RonakornST/CAN_Shield/CAN_Shield.step

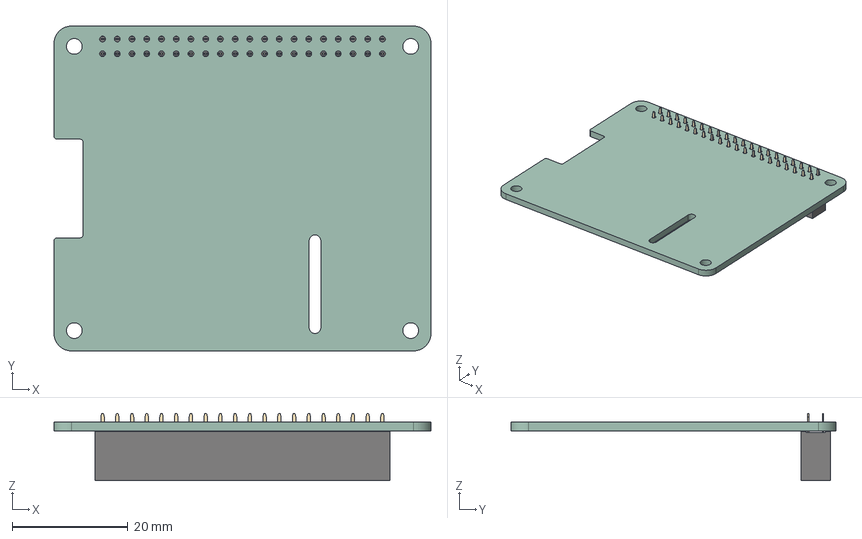
[picture p1: CAD file, 2025-09-22]
CAN_Shield.step
65.0 x 56.0 x 11.6 mm
PinSocket_2x20_P2.54mm_Vertical
CAN_Shield_PCB
