RonakornST/CAN_Shield/CAN_Shield.kicad_pcb

## KiCad design CAN_Shield.kicad_pcb (2025-09-29)

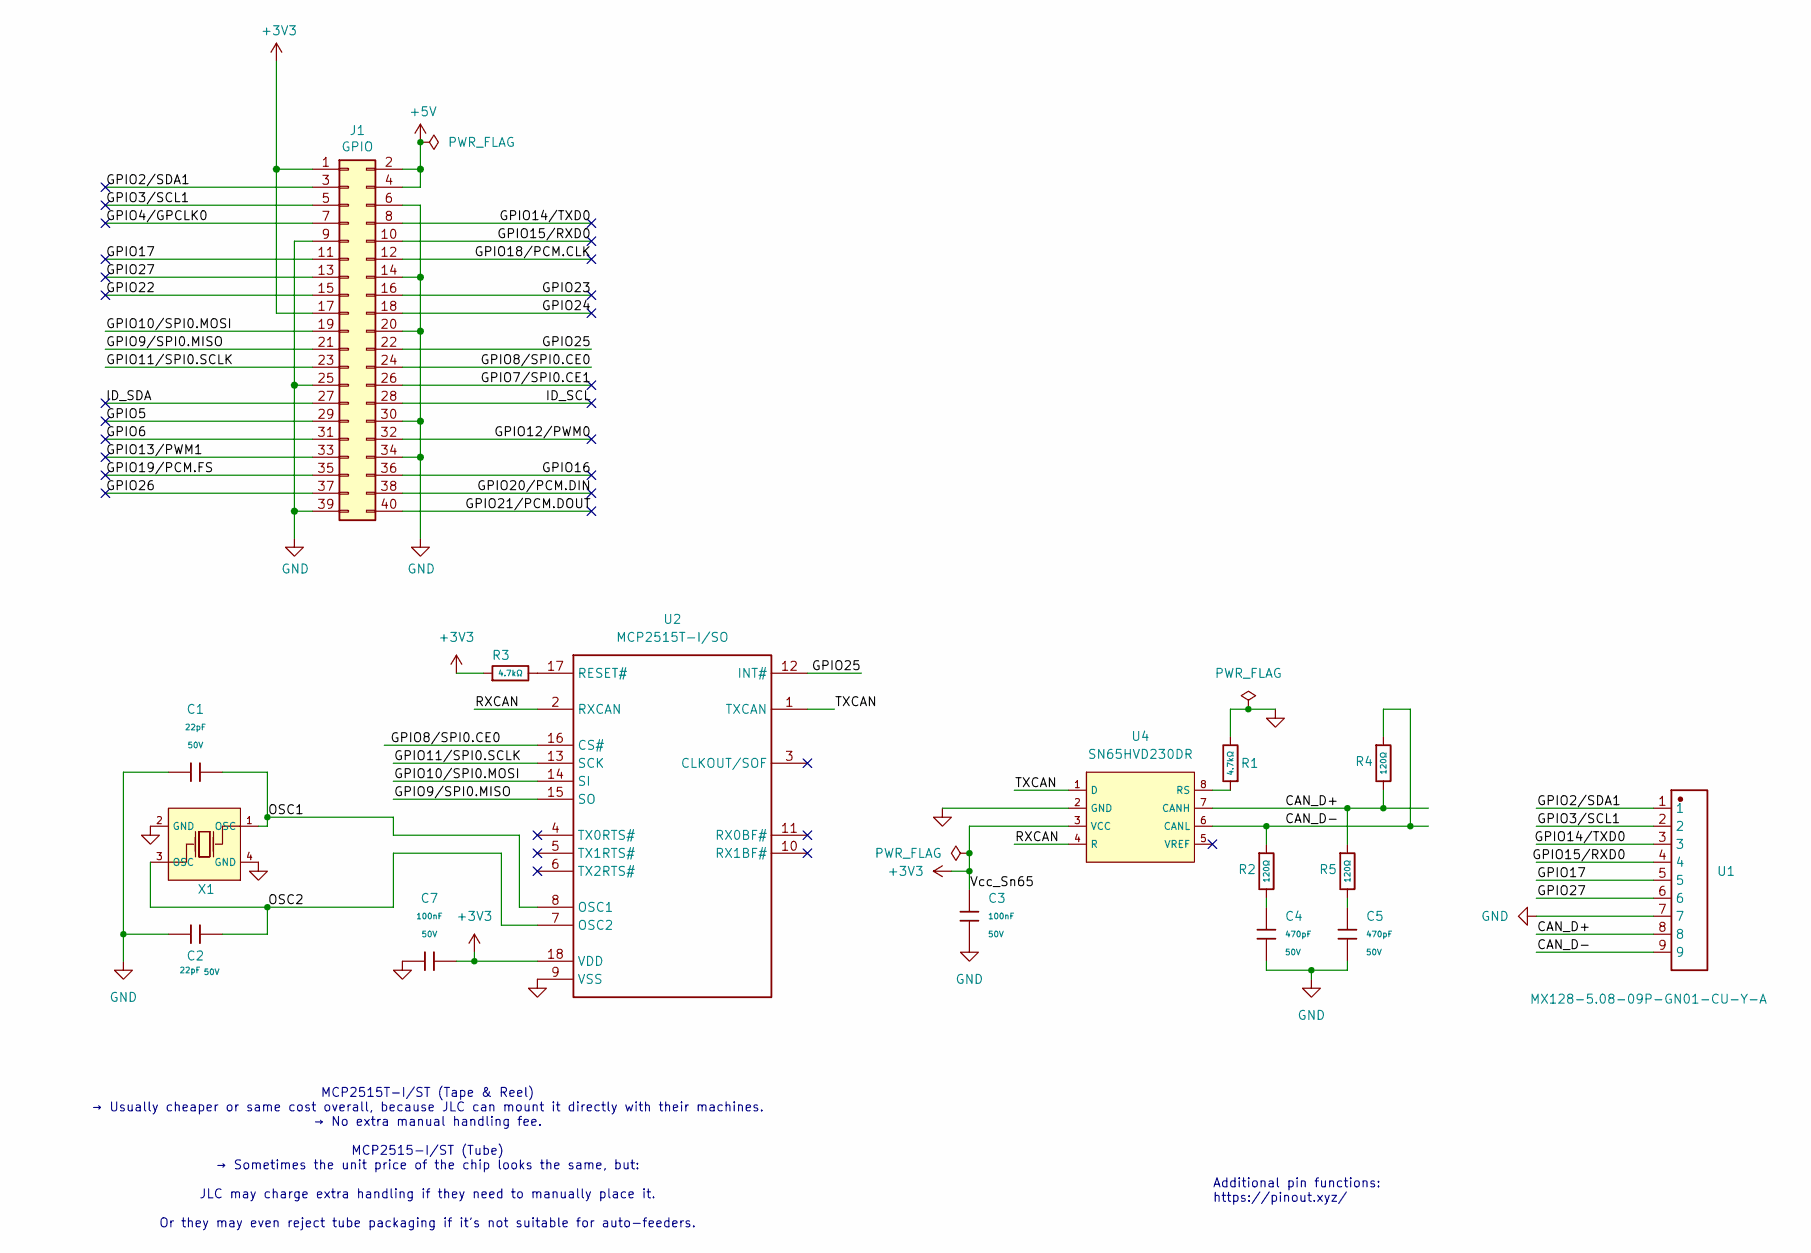
[picture p2: schematic CAN_Shield.kicad_sch]

Parts:
C1, C2: 22pF; C_0402; Voltage Rated 50V; Tolerance ±5%; Part 0402CG220J500NT; LCSC C1555
C3, C7: 100nF; C_0603; Voltage Rated 50V; Tolerance ±10%; Part CC0603KRX7R9BB104; LCSC C14663
C4, C5: 470pF; C_0402; Voltage Rated 50V; Tolerance ±10%; Part 0402B471K500NT; LCSC C1537
J1: GPIO; PinSocket_2x20_P2.54mm_Vertical
R1, R3: 4.7kΩ; R_0402; Overload Voltage (Max) 50V; Tolerance ±1%; Part 0402WGF4701TCE; LCSC C25900
R2, R4, R5: 120Ω; R_0603; Overload Voltage (Max) 75V; Tolerance ±1%; Part 0603WAF1200T5E; LCSC C22787
U1: MX128-5.08-09P-GN01-CU-Y-A; CONN-TH_9P-P5.08_MX128-5.08-09P-GN01-CU-Y-A; Manufacturer Part MX128-5.08-09P-GN01-Cu-Y-A
U2: MCP2515T-I/SO; MCP2515T-IST_SOIC-18_L11.6-W7.5-P1.27-LS10.3-BL; Manufacturer Part MCP2515T-I/SO
U4: SN65HVD230DR; SOIC-8_L4.9-W3.9-P1.27-LS6.0-BL; Supply Voltage 3V~3.6V; Part SN65HVD230DR; LCSC C12084
X1: X322516MLB4SI; OSC-SMD_4P-L3.2-W2.5-BL; Frequency Tolerance ±10ppm; Part X322516MLB4SI; LCSC C13738

Connections:
+3V3: C3.1, C7.2, J1.1, J1.17, R3.1, U2.18 (VDD), U4.3 (VCC)
+5V: J1.2, J1.4
/CAN_D+: R4.2, R5.1, U1.8, U4.7 (CANH)
/CAN_D-: R2.1, R4.1, U1.9, U4.6 (CANL)
/GPIO2/SDA1: J1.3, U1.1
/GPIO3/SCL1: J1.5, U1.2
/GPIO4/GPCLK0: J1.7
/GPIO5: J1.29
/GPIO6: J1.31
/GPIO7/SPI0.CE1: J1.26
/GPIO8/SPI0.CE0: J1.24, U2.16 (CS#)
/GPIO9/SPI0.MISO: J1.21, U2.15 (SO)
/GPIO10/SPI0.MOSI: J1.19, U2.14 (SI)
/GPIO11/SPI0.SCLK: J1.23, U2.13 (SCK)
/GPIO12/PWM0: J1.32
/GPIO13/PWM1: J1.33
/GPIO14/TXD0: J1.8, U1.3
/GPIO15/RXD0: J1.10, U1.4
/GPIO16: J1.36
/GPIO17: J1.11, U1.5
/GPIO18/PCM.CLK: J1.12
/GPIO19/PCM.FS: J1.35
/GPIO20/PCM.DIN: J1.38
/GPIO21/PCM.DOUT: J1.40
/GPIO22: J1.15
/GPIO23: J1.16
/GPIO24: J1.18
/GPIO25: J1.22, U2.12 (INT#)
/GPIO26: J1.37
/GPIO27: J1.13, U1.6
/ID_SCL: J1.28
/ID_SDA: J1.27
/OSC1: C1.2, U2.8 (OSC1), X1.1 (OSC)
/OSC2: C2.2, U2.7 (OSC2), X1.3 (OSC)
/RXCAN: U2.2 (RXCAN), U4.4 (R)
/TXCAN: U2.1 (TXCAN), U4.1 (D)
GND: C1.1, C2.1, C3.2, C4.2, C5.2, C7.1, J1.6, J1.9, J1.14, J1.20, J1.25, J1.30, J1.34, J1.39, R1.2, U1.7, U2.9 (VSS), U4.2 (GND), X1.2 (GND), X1.4 (GND)
unnamed: C4.1, R2.2
unnamed: C5.1, R5.2
unnamed: R3.2, U2.17 (RESET#)
unnamed: R1.1, U4.8 (RS)

Notes on the sheet:
Additional pin functions: https://pinout.xyz/
MCP2515T-I/ST (Tape & Reel) → Usually cheaper or same cost overall, because JLC can mount it directly with their machines. → No extra manual handling fee. MCP2515-I/ST (Tube) → Sometimes the unit price of the chip looks the same, but: JLC may charge extra handling if they need to manually place it.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

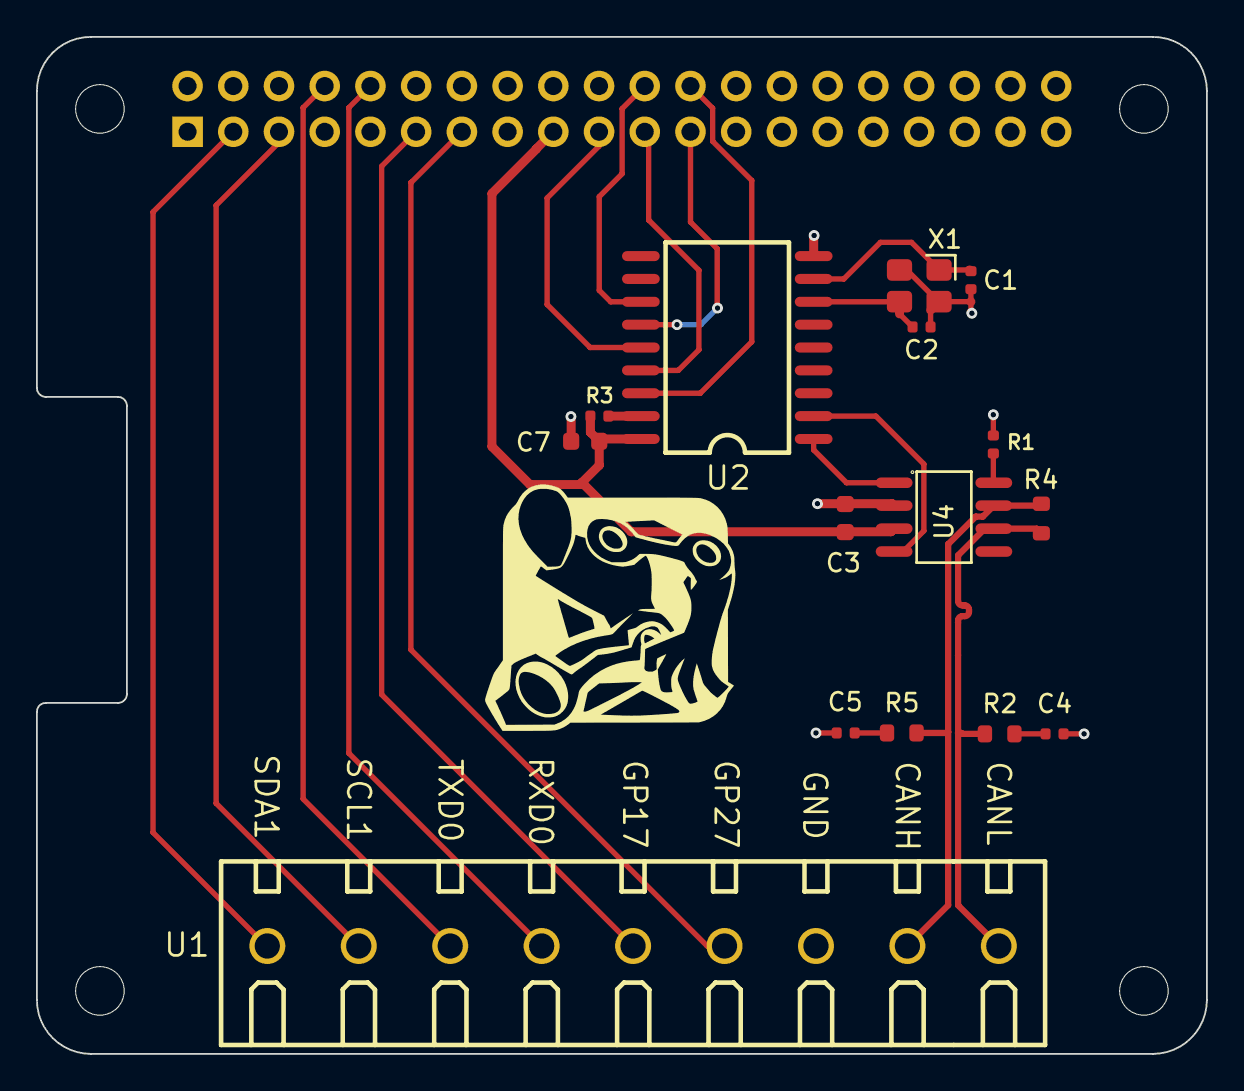
[picture p3: board CAN_Shield.kicad_pcb from above]

Board: 2 copper layers, 65.0 x 56.5 mm, 20 parts (1 on the bottom side), 24 nets.

Other parts of the board:
MH1, MH2, MH3, MH4: MountingHole_2.7mm_M2.5
