RonakornST/CAN_Shield/(commit log)

2025-09-22 Add .gitattributes and normalize line endings
    [CAN_Shield.kicad_pcb, CAN_Shield.kicad_sch, CAN_Shield.step]
2025-09-24 finished layout with 9 pin screw terminal, Unfinished edge extend and diff pair CAN
    [BOM-CAN_Shield.csv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]
2025-09-24 change from gpio to gnd at screw terminal and add copper pour for gnd
    [CAN_Shield.kicad_pcb, CAN_Shield.kicad_sch]
2025-09-24 add R and C to CAN H,L diff pair
    [CAN_Shield.kicad_pcb]
2025-09-24 add silk screen for pin of screw terminal
    [CAN_Shield.kicad_pcb, bom.csv, designators.csv, positions.csv]
2025-09-24 fix silkscreen overlapse by editing screw terminal footprint
2025-09-24 fix erc (thermal relief connection to zone incomplete (min spoke count 2 actual 1) by edit thermal relief gap from 0.5 to 0.3 mm
    [CAN_Shield.kicad_pcb]
2025-09-24 fix warning about not enough clearance between gnd pour around gpio header
2025-09-25 remove transfer via and fix erc: logo silk screen
    [designators.csv]
2025-09-25 extend pcb edge for smt header by double click the line and change from User.Drawing to Edgecuts
2025-09-26 change can diff pair trace width to 0.35 mm get 133ohm zdiff
    [CAN_Shield.kicad_pcb, CAN_Shield.kicad_sch, positions.csv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]
2025-09-29 tune CAN diff pair skew
    [CAN_Shield.kicad_pcb, CAN_Shield.kicad_sch]
